meduag/EstimuladorV1/PCB/Medir corriente/otros/senales/T0000.PNG

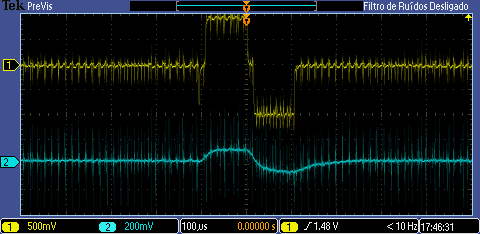
PCB/Medir corriente/otros/senales/T0000.PNG
