meduag/EstimuladorV1/PCB/Medir corriente/otros/senales/T0001.PNG

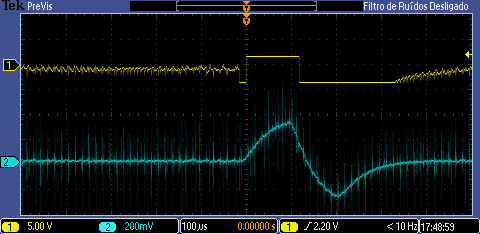
PCB/Medir corriente/otros/senales/T0001.PNG
