meduag/EstimuladorV1/PCB/Medir corriente/otros/senales/T0002.PNG

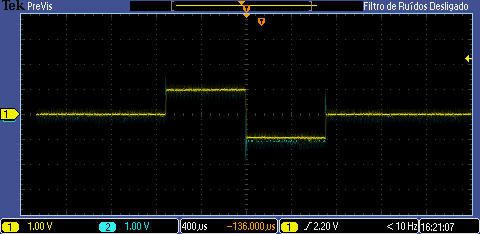
PCB/Medir corriente/otros/senales/T0002.PNG
