meduag/EstimuladorV1/PCB/Medir corriente/otros/senales/T0003.PNG

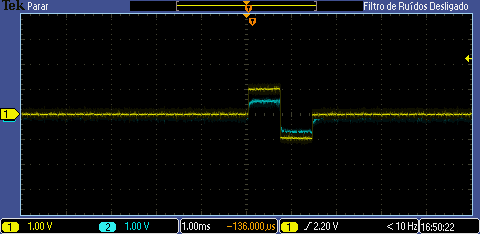
PCB/Medir corriente/otros/senales/T0003.PNG
