meduag/EstimuladorV1/PCB/Medir corriente/otros/senales/T0004.PNG

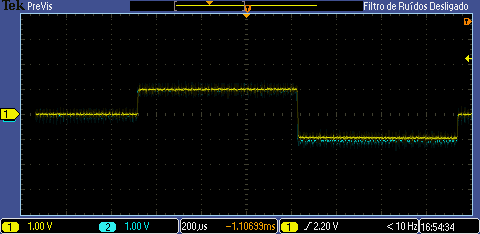
PCB/Medir corriente/otros/senales/T0004.PNG
