meduag/EstimuladorV1/PCB/Medir corriente/otros/testePCB/1ma 100hz 700us/T0000.PNG

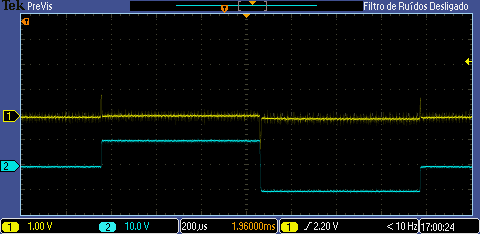
PCB/Medir corriente/otros/testePCB/1ma 100hz 700us/T0000.PNG
