meduag/EstimuladorV1/PCB/Medir corriente/otros/testePCB/10 ma 20 hz 100us/T0000.PNG

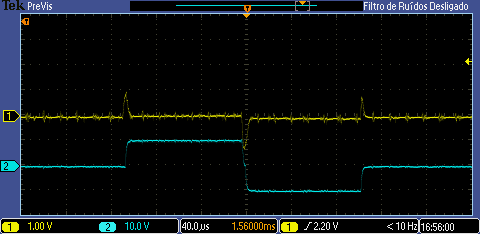
PCB/Medir corriente/otros/testePCB/10 ma 20 hz 100us/T0000.PNG
