meduag/EstimuladorV1/PCB/Medir corriente/otros/testePCB/sinal filtrado 1mA/T0000.PNG

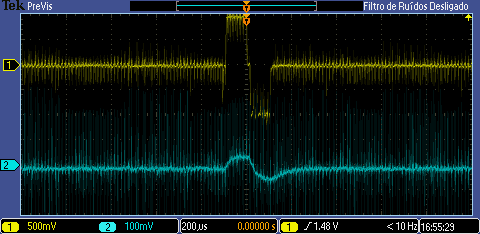
PCB/Medir corriente/otros/testePCB/sinal filtrado 1mA/T0000.PNG
