meduag/EstimuladorV1/PCB/Medir corriente/otros/testePCB/sinal filtrado con carga desconectada/T0000.PNG

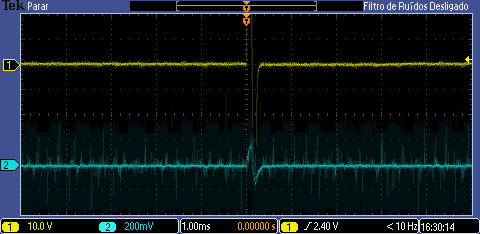
PCB/Medir corriente/otros/testePCB/sinal filtrado con carga desconectada/T0000.PNG
