meduag/EstimuladorV1/PCB/Medir corriente/otros/testePCB/sinal filtrado despues do subtrator con 10ma/T0000.PNG

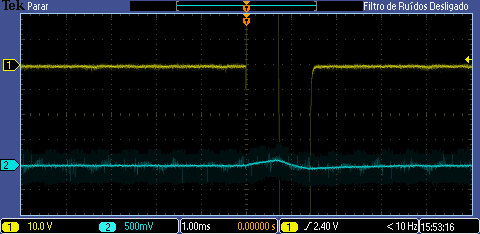
PCB/Medir corriente/otros/testePCB/sinal filtrado despues do subtrator con 10ma/T0000.PNG
