meduag/EstimuladorV1/PCB/Medir corriente/otros/testePCB/sistema de seg top.pdf

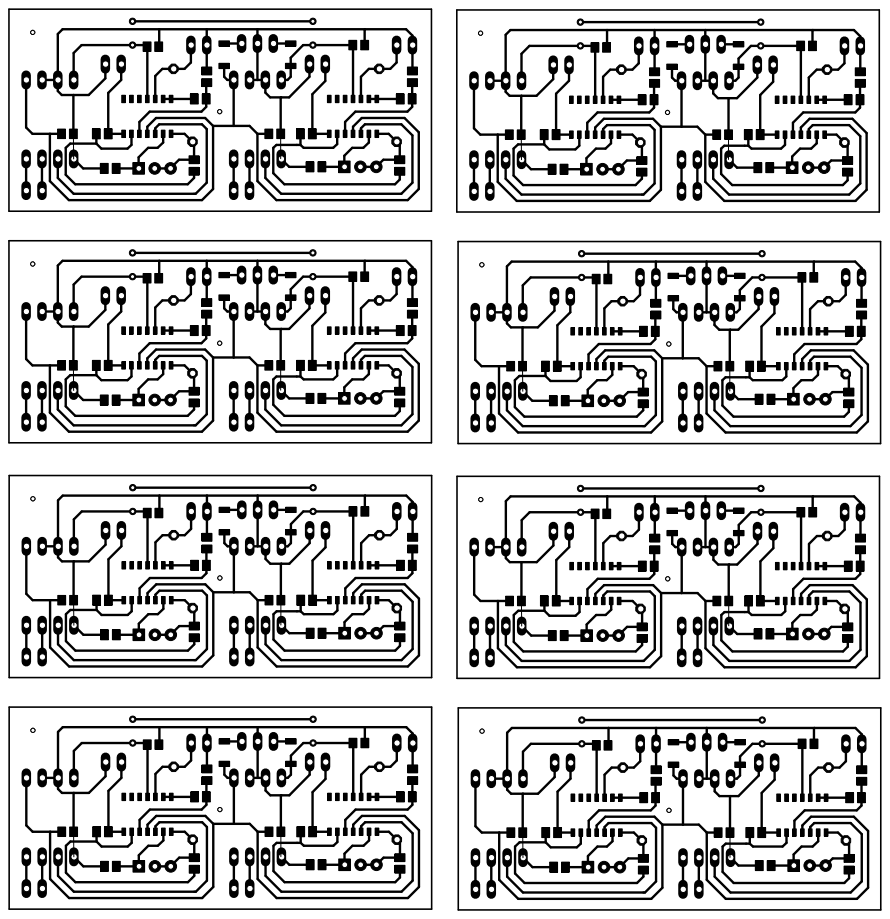
[picture p11: page 1]
