meduag/EstimuladorV1/(list of files, drawings)

Other design files:
PCB/Medir corriente/otros/senales/filtro.pdsprj
