meduag/EstimuladorV1/PCB/Medir corriente/AD629 shield.brd

## EAGLE design PCB/Medir corriente/AD629 shield.brd (2019-03-07)

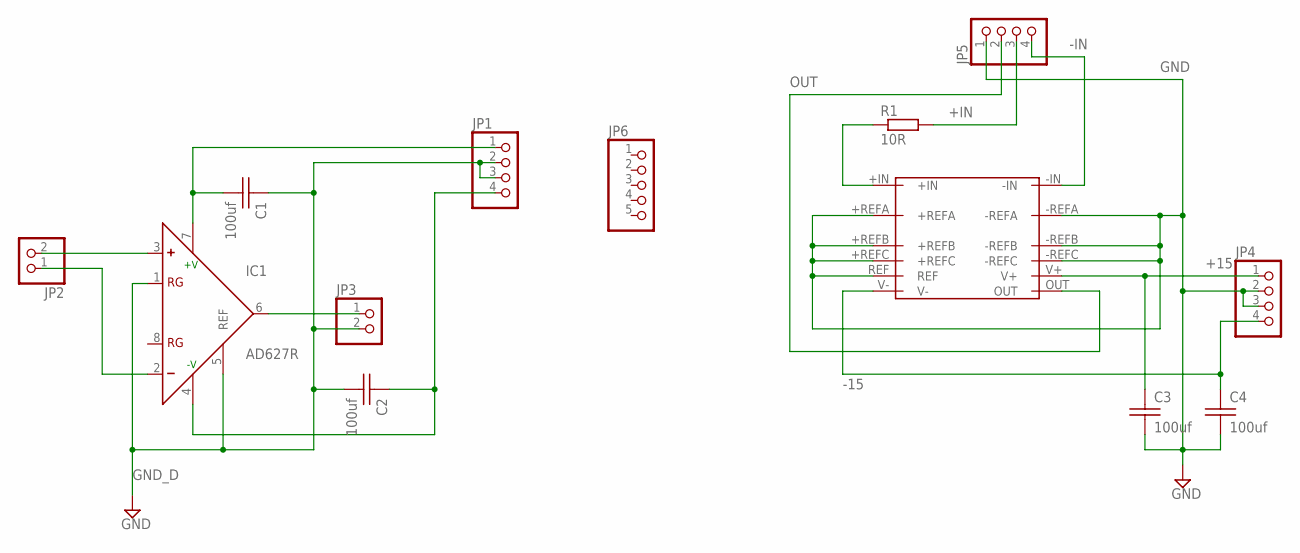
[picture p19: schematic AD629 shield.sch]

Parts:
C1, C2, C3, C4: 100uf; CAP_CER_SMD-0805
IC1: AD627R; SO8
JP1, JP4, JP5: PINHD-1X4; 1X04
JP2, JP3: PINHD-1X2; 1X02
JP6: PINHD-1X5; 1X05
R1: 10R; RESISTENCIA_0805
U$1: LT6375; LT6375_MS16(12)

Connections:
+15: C3.1, JP4.1, U$1.V+
+IN: JP5.3, R1.2
-15: C4.1, JP4.4, U$1.V-
-IN: JP5.4, U$1.-IN
GND: C3.2, C4.2, JP4.2, JP4.3, JP5.1, U$1.+REFA, U$1.+REFB, U$1.+REFC, U$1.-REFA, U$1.-REFB, U$1.-REFC, U$1.REF
GND_D: C1.1, C2.2, IC1.1 (RG), IC1.5 (REF), JP1.2, JP1.3, JP3.2
unnamed: IC1.3 (+), JP2.2
unnamed: IC1.2 (-), JP2.1
unnamed: C1.2, IC1.7 (+V), JP1.1
unnamed: C2.1, IC1.4 (-V), JP1.4
unnamed: IC1.6 (OUT), JP3.1
unnamed: R1.1, U$1.+IN
OUT: JP5.2, U$1.OUT

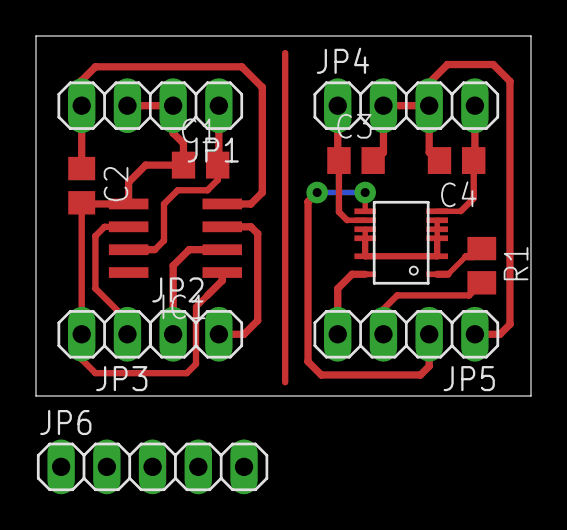
[picture p20: board AD629 shield.brd from above]

Board: 2 copper layers, 27.5 x 20.0 mm, 13 parts (0 on the bottom side), 13 nets.
