meduag/EstimuladorV1/(commit log)

2019-03-07 Inicio final version end tese
    cosas para hacer en el link https://trello.com/c/CMSjg6Bh/17-estimulema
    [AD629 shield.brd, AD629 shield.sch, Estimulema v2.brd, Estimulema v2.sch, filtro.pdsprj]
2019-03-11 Fallos en la interface y control en el ino
    *- toca dividir por 10 el ton en el ino, en la interface ya esta corregido
    *- colocar na interface para teste tex
    *-
